zEhmsy/lightflow/3d_files/Base.stl

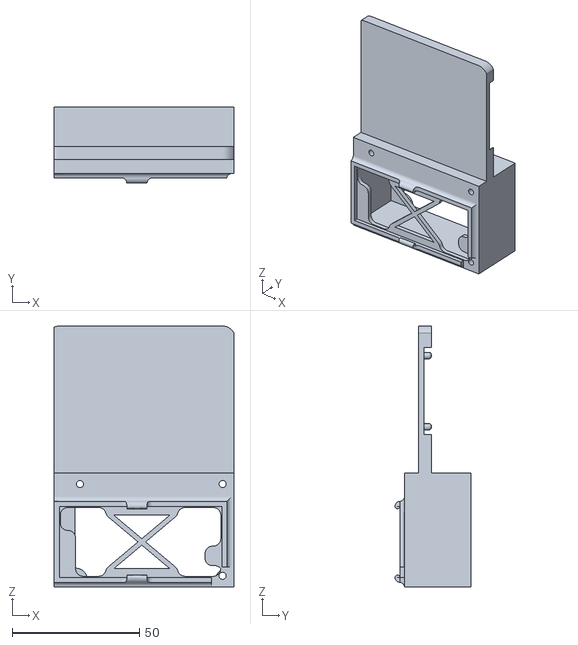
[picture p8: CAD file, 2025-08-26]
3d_files/Base.stl
70.5 x 29.9 x 102.4
