zEhmsy/lightflow/(notices)

Notices in the files:
README.md:
MIT License
